janelia-kicad/servo_controller_3x2/project.org

* Header                                                           :noexport:

  #+MACRO: name servo_controller_3x2
  #+MACRO: version 1.0
  #+MACRO: license Open-Source Hardware
  #+MACRO: url https://github.com/janelia-kicad/servo_controller_3x2
  #+AUTHOR: Peter Polidoro
  #+EMAIL: peter@polidoro.io

* Description

  This device independently controls up to 16 5V hobby servos.

* Assembly Instructions

  - Solder surface mount and through hole components onto the pcb.
