janelia-kicad/servo_controller_3x2/schematic/servo_controller_3x2.pdf

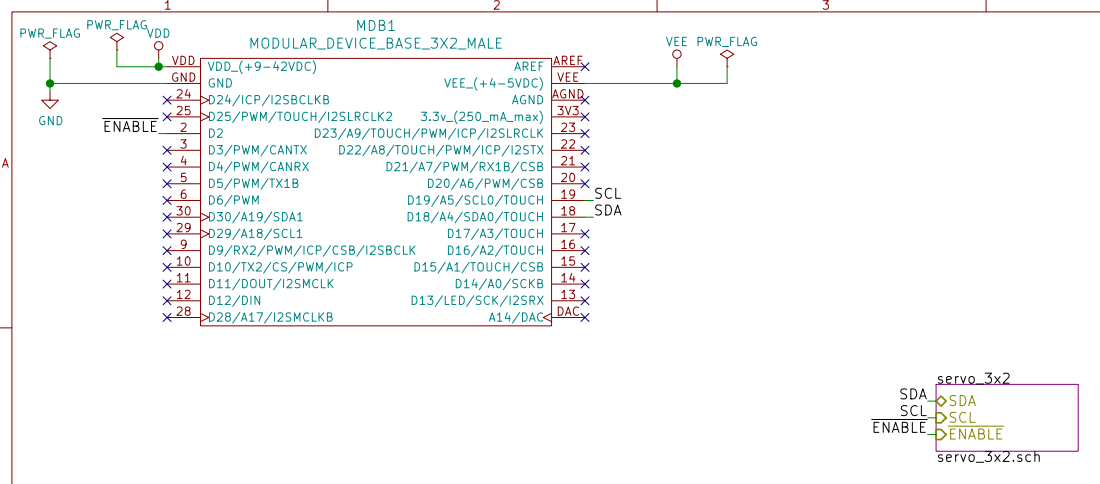
[picture p5: page 1]

File: servo_controller_3x2.sch Sheet: / Janelia

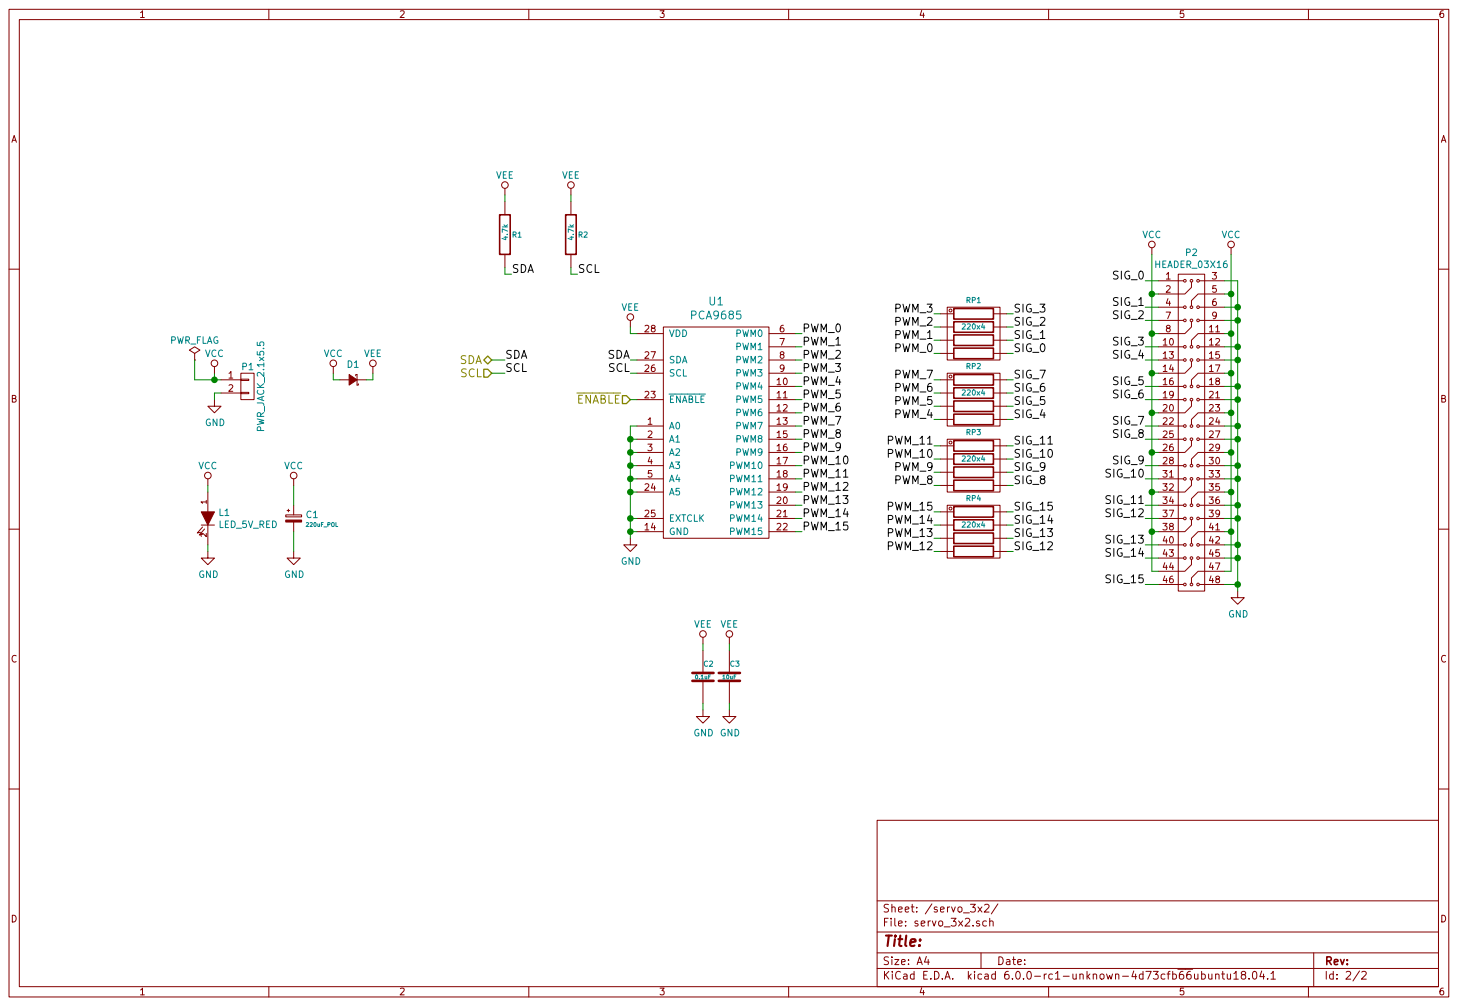
[picture p6: page 2]

13 | 15
14 16 | 17 18

25 | 27
26 28 | 29 30

0.1uF VEE VEE GND GND
