janelia-kicad/servo_controller_3x2/gerbers/gerbers.pdf

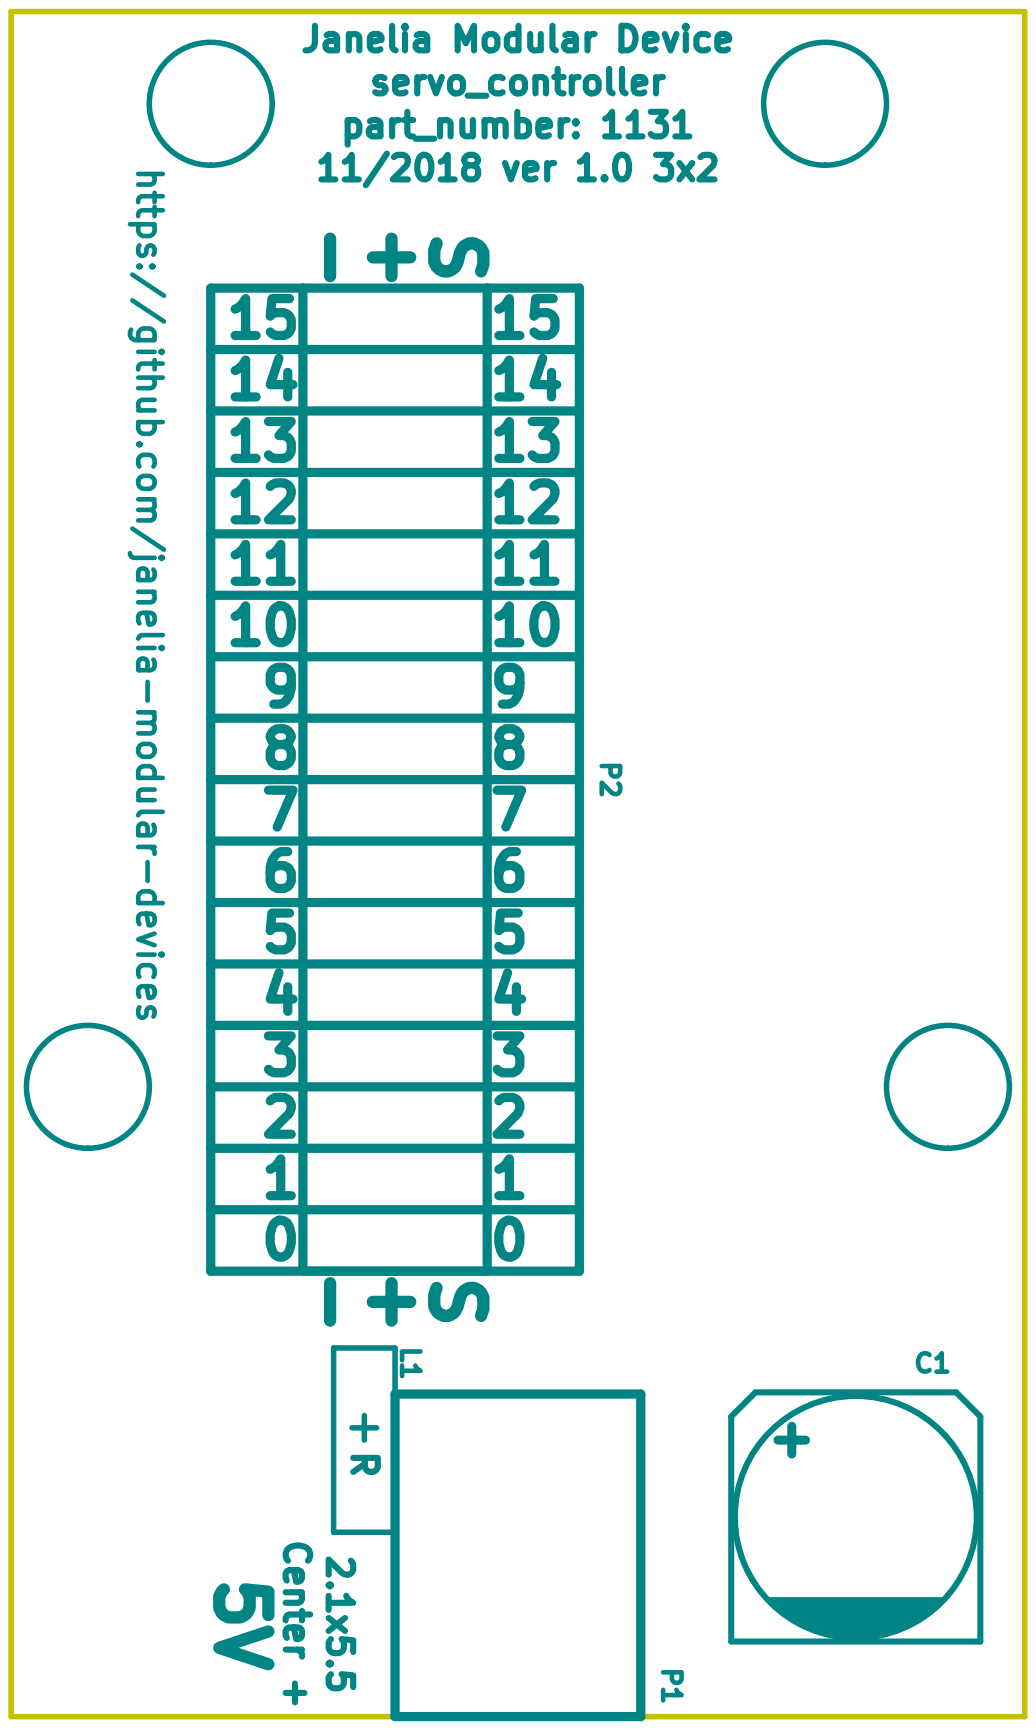
[picture p7: page 1]

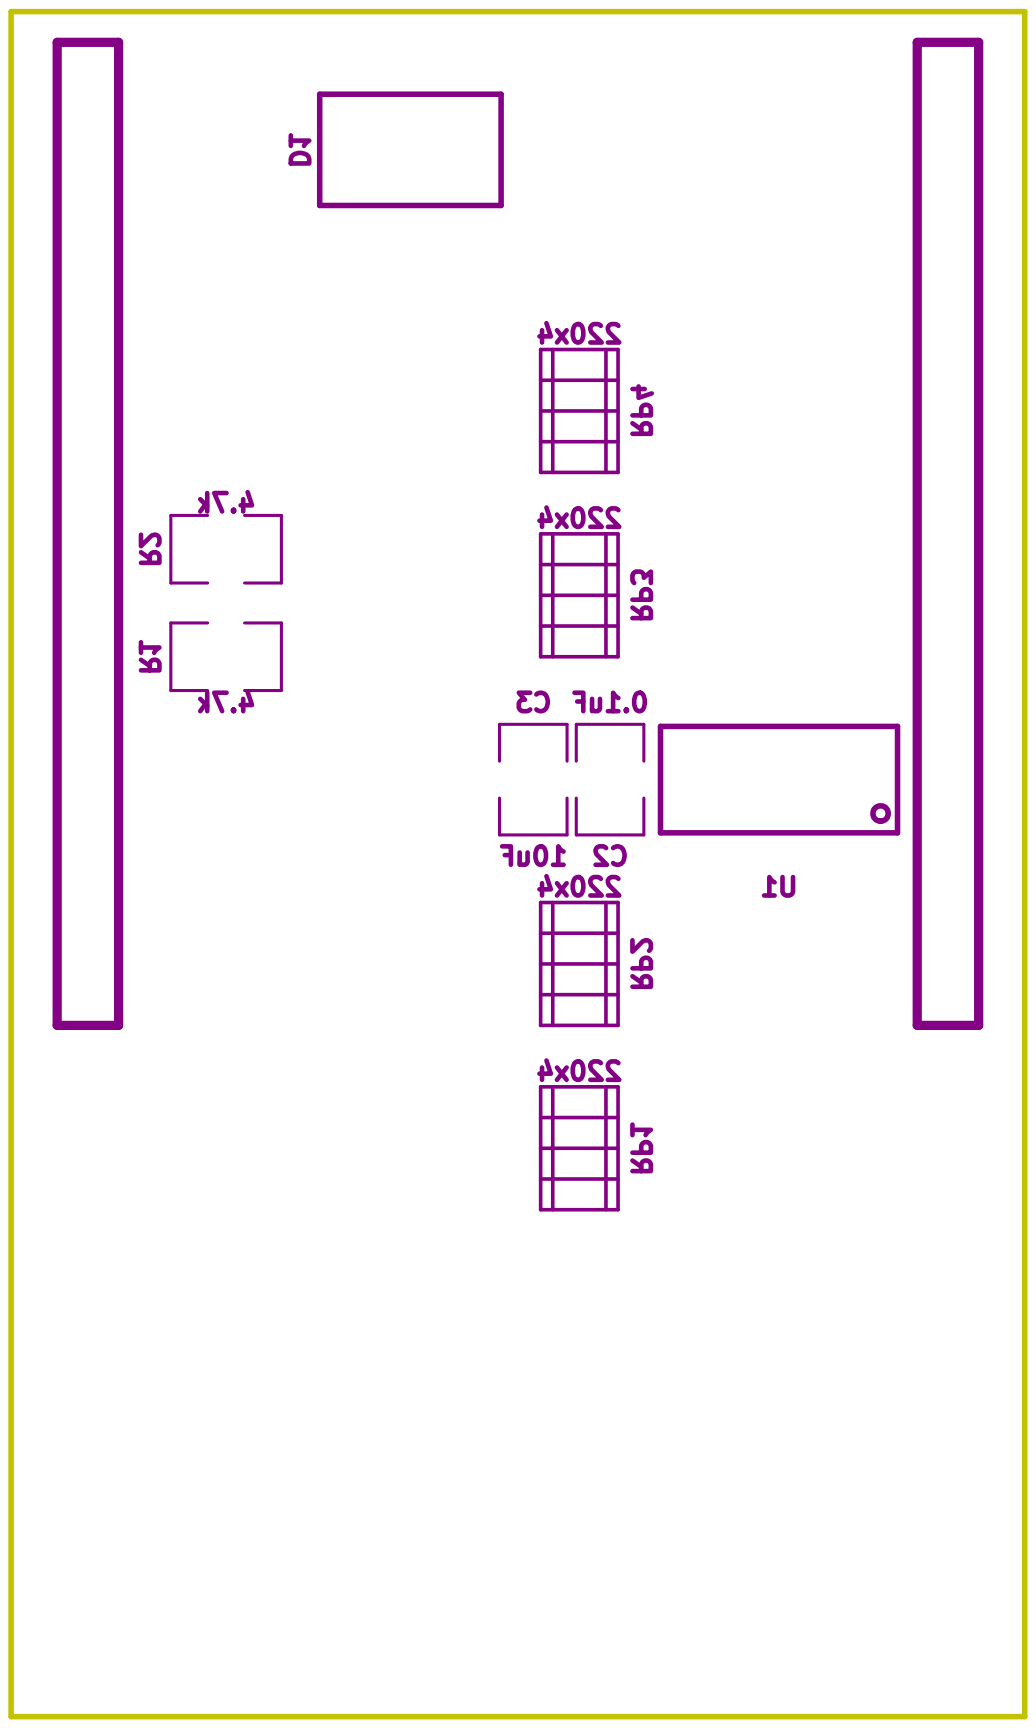
[picture p8: page 2]
