janelia-kicad/servo_controller_3x2/servo_controller_3x2.kicad_pcb

## KiCad design servo_controller_3x2.kicad_pcb (2018-11-28)

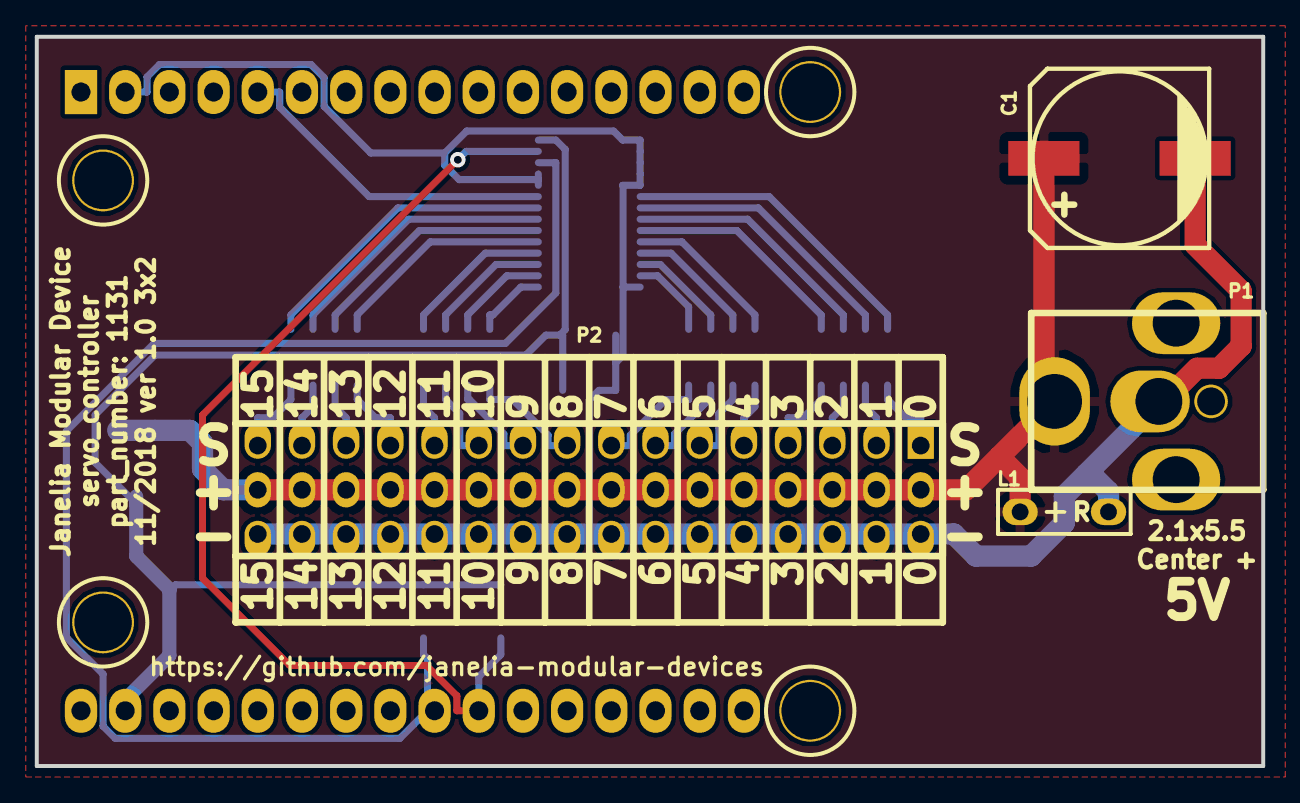
[picture p9: board servo_controller_3x2.kicad_pcb from above]

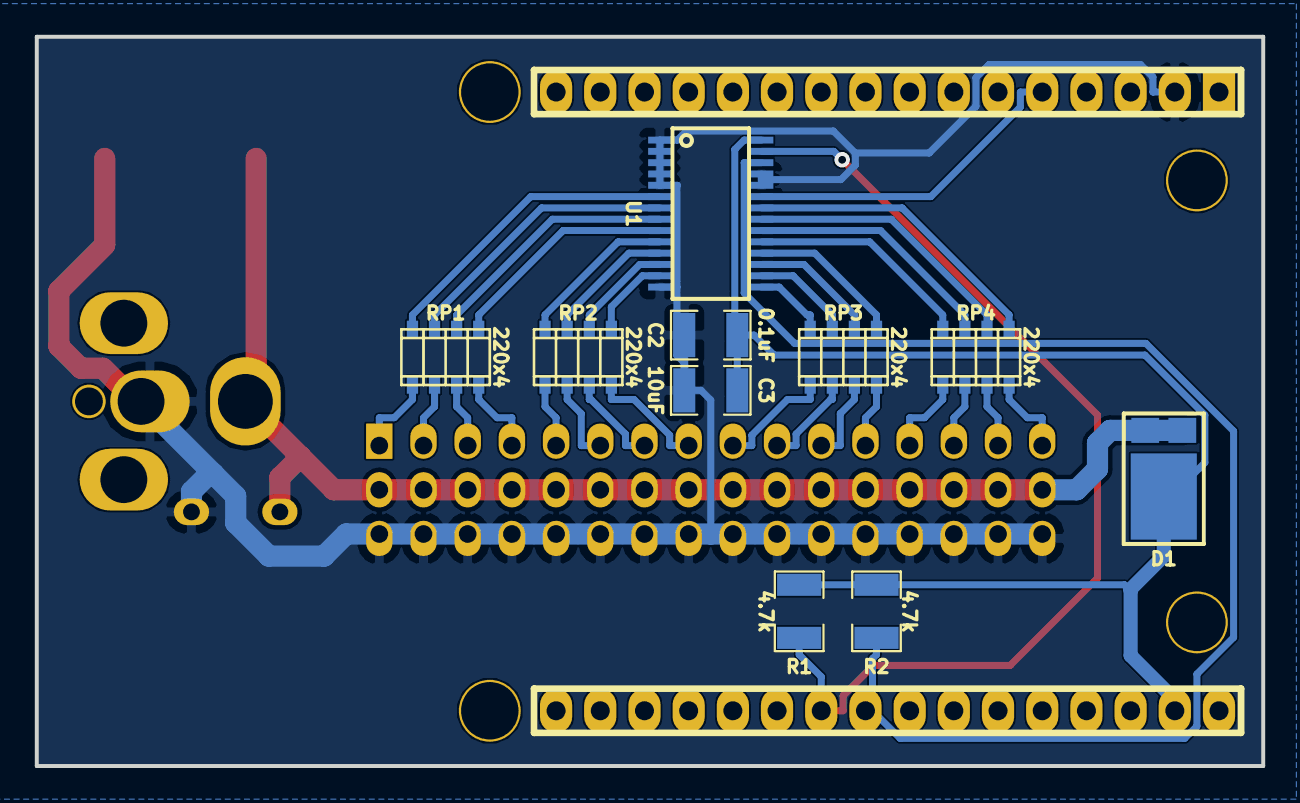
[picture p10: board servo_controller_3x2.kicad_pcb from below]

Board: 2 copper layers, 70.5 x 41.9 mm, 15 parts (10 on the bottom side), 38 nets.

Parts:
C1: 220uF_POL; C_ELEC_10
C2: 0.1uF; SM1210
C3: 10uF; SM1210
D1: diode_schottky_45V_10A; CFP15
L1: LED_5V_RED; LED_555-3XXX_R
MDB1: VAL**; MODULAR_DEVICE_BASE_3X2_MALE
P1: PWR_JACK_2.1x5.5; DCJACK_2PIN_HIGHCURRENT
P2: HEADER_03X16; HEADER_03x16
R1, R2: 4.7k; SM1210
RP1, RP2, RP3, RP4: 220x4; RESISTOR_PACK_SM1206x4
U1: PCA9685; TSSOP28

Connections:
/SCL: MDB1.19, R2.2, U1.26
/SDA: MDB1.18, R1.2, U1.27
/servo_3x2/PWM_0: RP1.7, U1.6
/servo_3x2/PWM_1: RP1.5, U1.7
/servo_3x2/PWM_2: RP1.3, U1.8
/servo_3x2/PWM_3: RP1.1, U1.9
/servo_3x2/PWM_4: RP2.7, U1.10
/servo_3x2/PWM_5: RP2.5, U1.11
/servo_3x2/PWM_6: RP2.3, U1.12
/servo_3x2/PWM_7: RP2.1, U1.13
/servo_3x2/PWM_8: RP3.7, U1.15
/servo_3x2/PWM_9: RP3.5, U1.16
/servo_3x2/PWM_10: RP3.3, U1.17
/servo_3x2/PWM_11: RP3.1, U1.18
/servo_3x2/PWM_12: RP4.7, U1.19
/servo_3x2/PWM_13: RP4.5, U1.20
/servo_3x2/PWM_14: RP4.3, U1.21
/servo_3x2/PWM_15: RP4.1, U1.22
/servo_3x2/SIG_0: P2.1, RP1.8
/servo_3x2/SIG_1: P2.4, RP1.6
/servo_3x2/SIG_2: P2.7, RP1.4
/servo_3x2/SIG_3: P2.10, RP1.2
/servo_3x2/SIG_4: P2.13, RP2.8
/servo_3x2/SIG_5: P2.16, RP2.6
/servo_3x2/SIG_6: P2.19, RP2.4
/servo_3x2/SIG_7: P2.22, RP2.2
/servo_3x2/SIG_8: P2.25, RP3.8
/servo_3x2/SIG_9: P2.28, RP3.6
/servo_3x2/SIG_10: P2.31, RP3.4
/servo_3x2/SIG_11: P2.34, RP3.2
/servo_3x2/SIG_12: P2.37, RP4.8
/servo_3x2/SIG_13: P2.40, RP4.6
/servo_3x2/SIG_14: P2.43, RP4.4
/servo_3x2/SIG_15: P2.46, RP4.2
/~ENABLE: MDB1.2, U1.23
GND: C1.2, C2.2, C3.2, L1.2, MDB1.GND, P1.2, P2.3, P2.6, P2.9, P2.12, P2.15, P2.18, P2.21, P2.24, P2.27, P2.30, P2.33, P2.36, P2.39, P2.42, P2.45, P2.48, U1.1, U1.2, U1.3, U1.4, U1.5, U1.14, U1.24, U1.25
VCC: C1.1, D1.2, L1.1, P1.1, P2.2, P2.5, P2.8, P2.11, P2.14, P2.17, P2.20, P2.23, P2.26, P2.29, P2.32, P2.35, P2.38, P2.41, P2.44, P2.47
VEE: C2.1, C3.1, D1.1, MDB1.VEE, R1.1, R2.1, U1.28
