janelia-kicad/servo_controller_3x2/(commit log)

2018-11-26 Initial commit.
    [servo_controller_3x2.kicad_pcb, servo_controller_3x2.sch]
2018-11-26 Added components.
    [servo_3x2.sch, servo_controller_3x2.kicad_pcb, servo_controller_3x2.sch]
2018-11-27 Progress towards v1.0.
    [servo_3x2.sch, servo_controller_3x2.dsn, servo_controller_3x2.kicad_pcb, servo_controller_3x2.sch, supplemental_digikey_parts.csv]
2018-11-27 Finished routing.
    [servo_controller_3x2.dsn, servo_controller_3x2.kicad_pcb]
2018-11-28 Finished v1.0.
    [servo_controller_3x2.kicad_pcb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]
2018-11-28 Finished documentation v1.0.
    [digikey_order.csv, digikey_parts.csv]
2021-09-21 Remove ignored files
    [servo_controller_3x2.dsn]
